gcoonrod/sunrise-breakout/README.md

# Sunrise Breakout

Breadboard friendly breakout for RGBW LEDs, LP5012, and LM3410.
