gcoonrod/sunrise-breakout/QBLP679-RGBXW/QBLP679-RGBXW.step

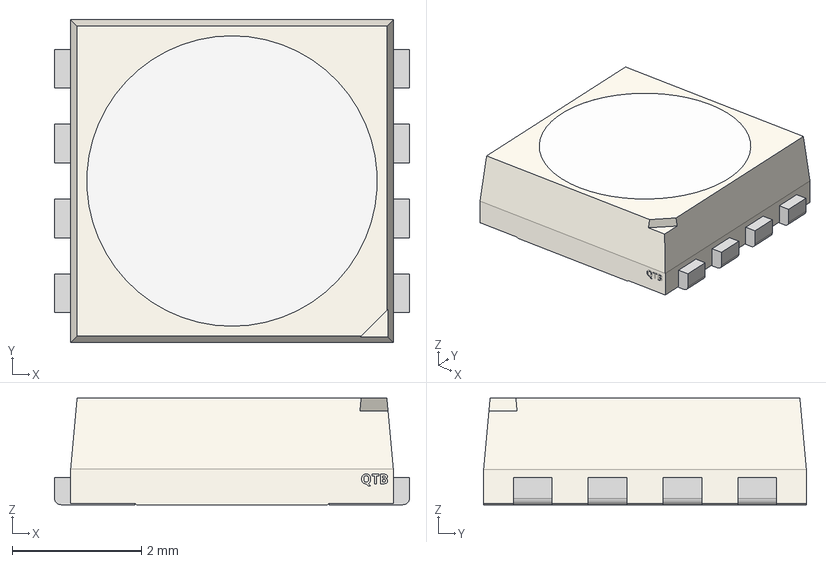
[picture p1: CAD file, 2023-01-06]
QBLP679-RGBXW/QBLP679-RGBXW.step
5.50 x 5.00 x 1.65 mm
