gcoonrod/sunrise-breakout/(list of files, cad)

Other CAD files:
QBLP679-RGBXW/QBLP679-RGBXW.iges
