gcoonrod/sunrise-breakout/sunrise.kicad_pcb

## KiCad design sunrise.kicad_pcb (2023-01-06)

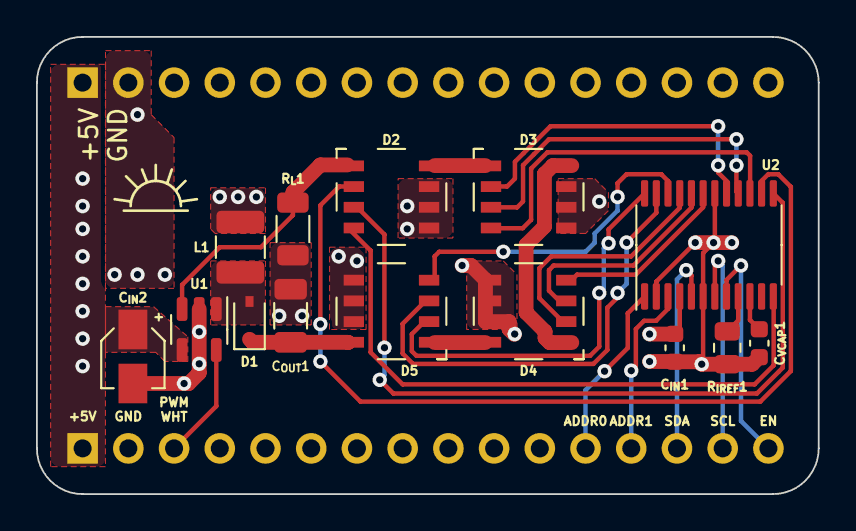
[picture p2: board sunrise.kicad_pcb from above]

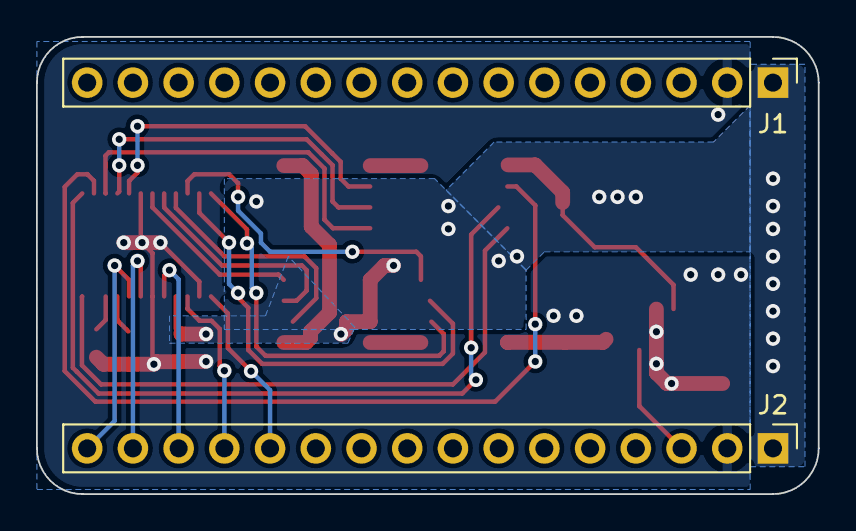
[picture p3: board sunrise.kicad_pcb from below]

Board: 2 copper layers, 43.4 x 25.4 mm, 16 parts (2 on the bottom side), 28 nets.

Parts:
C_{IN}1: 1u; C_0603_1608Metric
C_{IN}2: 10u; CP_Elec_3x5.3
C_{OUT}1: 1n2; C_1206_3216Metric
C_{VCAP}1: 1u; C_0603_1608Metric
D1: 30V; D_SOD-323
D2, D3, D4, D5: LED_RGBW; LED_SMD5050-8
J1: TOP_HDR; PinHeader_1x16_P2.54mm_Vertical
J2: BTM_HDR; PinHeader_1x16_P2.54mm_Vertical
L1: 10u; L_1210_3225Metric
R_{IREF}1: 374; R_0805_2012Metric
R_{L}1: 10; R_1206_3216Metric
U1: LM3410; SOT-23-5
U2: LP5012; TSSOP-24_4.4x7.8mm_P0.65mm

Connections:
/ADDR0: J2.12, U2.1 (ADDR0)
/ADDR1: J2.13, U2.3 (ADDR1)
/DIM_WHT: J2.3, U1.5 (DIM)
/FB_WHT: D2.5, R_{L}1.1, U1.3 (FB)
/OUT0: D2.8, U2.12 (OUT0)
/OUT1: D2.7, U2.13 (OUT1)
/OUT2: D2.6, U2.14 (OUT2)
/OUT3: D3.8, U2.15 (OUT3)
/OUT4: D3.7, U2.16 (OUT4)
/OUT5: D3.6, U2.17 (OUT5)
/OUT6: D4.8, U2.19 (OUT6)
/OUT7: D4.7, U2.20 (OUT7)
/OUT8: D4.6, U2.21 (OUT8)
/OUT9: D5.8, U2.22 (OUT9)
/OUT10: D5.7, U2.23 (OUT10)
/OUT11: D5.6, U2.24 (OUT11)
/RGB_EN: J2.16, U2.8 (EN)
/SCL: J2.15, U2.7 (SCL)
/SDA: J2.14, U2.5 (SDA)
/SW_WHT: D1.2 (A), L1.2, U1.1 (SW)
/V_{OUT}_WHT: C_{OUT}1.1, D1.1 (K), D5.4
GND: C_{IN}1.2, C_{IN}2.2, C_{OUT}1.2, C_{VCAP}1.2, J1.2 (GND), J2.2, R_{IREF}1.1, R_{L}1.2, U1.2 (GND), U2.2 (AGND), U2.6 (PGND), U2.18 (DGND)
unnamed: C_{VCAP}1.1, U2.10 (VCAP)
unnamed: D2.4, D3.5
unnamed: D3.4, D4.5
unnamed: D4.4, D5.5
unnamed: R_{IREF}1.2, U2.9 (IREF)
VCC: C_{IN}1.1, C_{IN}2.1, D2.1, D2.2, D2.3, D3.1, D3.2, D3.3, D4.1, D4.2, D4.3, D5.1, D5.2, D5.3, J1.1 (VCC), J2.1, L1.1, U1.4 (VIN), U2.4 (VCC)
