gcoonrod/sunrise-breakout/(commit log)

2023-01-06 inital commit
    [QBLP679-RGBXW.iges, QBLP679-RGBXW.step, SunriseDisplay.kicad_sch, SunriseLEDControl.kicad_sch, sunrise.kicad_pcb, sunrise.kicad_sch]
2023-01-06 Update RGBW footprint and BOM.
    [sunrise.kicad_pcb, sunrise.kicad_sch]
